Yevgeniy-Olexandrenko/aym-streamer/README.md

# AYM Streamer

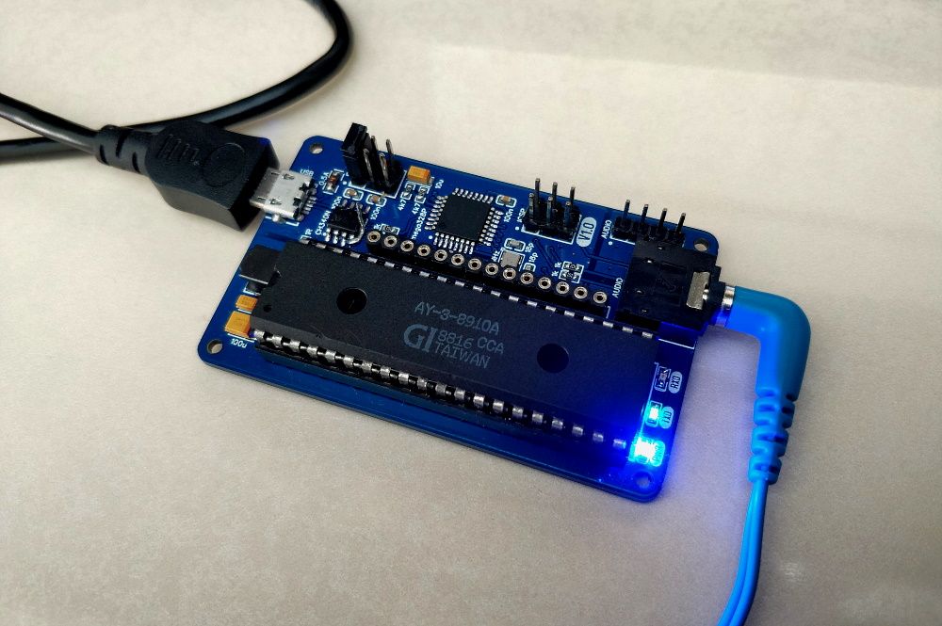
[picture p1: hardware/prototype.jpg]
