Yevgeniy-Olexandrenko/aym-streamer/hardware/README.md

PCB v1.1|PCB v1.2
-|-
|||
|||
|<div><ul><li>Fixed MCU-to-PSG data bus routing</li><li>Fixed MCU reset when uploading firmware via USB</li><li>First fully functional device</li></ul></div>|<ul><li>Micro USB input changed to USB Type-C</li><li>New trace routing for USB-to-Serial converter</li><li>L1 moved further away from the capacitors</li><li>More accurate traces around the MCU</li><li>New calculated resistors for LEDs</li><li>Added teardrops to traces</li><li>The device name is aligned along the PCB</li></ul>|
