Yevgeniy-Olexandrenko/aym-streamer/hardware/v1.2/AYM-Streamer-v1.2_LEDs.ods

Desired luminous intencity, mcd
10
FYLS-0603URC |  |  |  | FYLS-0603PGC |  |  |  | FYLS-0603UBC
RED |  |  |  | GREEN |  |  |  | BLUE
# | Uf, V | If, mA |  | # | Uf, V | If, mA |  | # | Uf, V | If, mA
1 | 1,70 | 1,00 |  | 1 | 2,60 | 0,50 |  | 1 | 2,60 | 1,00
2 | 1,75 | 1,75 |  | 2 | 2,65 | 1,00 |  | 2 | 2,65 | 1,50
3 | 1,80 | 2,50 |  | 3 | 2,70 | 1,50 |  | 3 | 2,70 | 2,00
4 | 1,85 | 4,50 |  | 4 | 2,75 | 2,50 |  | 4 | 2,75 | 2,75
5 | 1,90 | 6,50 |  | 5 | 2,80 | 3,50 |  | 5 | 2,80 | 3,50
6 | 1,95 | 9,00 |  | 6 | 2,85 | 4,75 |  | 6 | 2,85 | 5,00
7 | 2,00 | 11,50 |  | 7 | 2,90 | 6,00 |  | 7 | 2,90 | 6,50
8 | 2,05 | 13,75 |  | 8 | 2,95 | 7,00 |  | 8 | 2,95 | 7,25
9 | 2,10 | 16,00 |  | 9 | 3,00 | 8,00 |  | 9 | 3,00 | 8,00
10 | 2,15 | 20,50 |  | 10 | 3,05 | 10,25 |  | 10 | 3,05 | 10,25
11 | 2,20 | 25,00 |  | 11 | 3,10 | 12,50 |  | 11 | 3,10 | 12,50
 |  |  |  | 12 | 3,15 | 14,75 |  | 12 | 3,15 | 15,00
RED | GREEN | BLUE |  | 13 | 3,20 | 17,00 |  | 13 | 3,20 | 17,50
Iv, mcd @ If = 20 mA |  |  |  | 14 | 3,25 | 21,00 |  | 14 | 3,25 | 21,25
80 | 360 | 120 |  | 15 | 3,30 | 25,00 |  | 15 | 3,30 | 25,00
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
