Yevgeniy-Olexandrenko/aym-streamer/hardware/v1.2/AYM-Streamer-v1.2_BOM.tsv

ID | Name | Designator | Footprint | Quantity | Manufacturer Part | Manufacturer
1 | 100n | C4,C7,C8,C9,C10,C11,C15,C16,C20 | C0603 | 9
2 | 18p | C18,C19 | C0603 | 2
3 | 24K | R2,R4,R8,R11,R14,R19 | R0603 | 6
4 | 51R | R3,R15 | R0603 | 2
5 | 1K27 | R5 | R0603 | 1
6 | 4K3 | R6 | R0603 | 1
7 | 47K | R7,R13 | R0603 | 2
8 | 1K | R9,R10,R16,R17,R18 | R0603 | 5
9 | 1K4 | R21 | R0603 | 1
10 | 0R | R24 | R0603 | 1
11 | USB | USB1 | USB-C-7010ASV | 1 | GT-USB-7010ASV | G-Switch(品赞)
12 | 5.1K | R25,R26 | R0603 | 2
13 | TXD | LED2 | LED0603_GREEN | 1 | FYLS-0603PGC | FORYARD
14 | ATmega328P | U3 | TQFP-32_L7.0-W7.0-P0.80-LS9.0-BL | 1 | ATMEGA328P-AU | MICROCHIP
15 | 100u | C1,C6,C13 | CAP-SMD_L3.5-W2.8 | 3 | TAJB107K006RNJ | AVX
16 | 10u | C2,C3,C5,C12,C14,C17 | CAP-SMD_L3.2-W1.6-RD-1 | 6 | TAJA106K010RNJ | AVX
17 | 10K | R1,R12,R20,R22,R23 | R0603 | 5
18 | NE5532 | U1 | SOIC-8_L4.9-W3.9-P1.27-LS6.0-BL | 1 | NE5532DR | TI
19 | CH340N | U2 | SOP-8_L5.0-W4.0-P1.27-LS6.0-BL | 1 | CH340N | WCH(Jiangsu Qin Heng)
20 | PSG | LED3 | LED0603_BLUE | 1 | FYLS-0603UBC | FORYARD
21 | 1mH | L1 | IND-SMD_L5.8-W5.2_SCD0503T | 1 | YP0504-102M | YJYCOIN
22 | RXD | LED1 | LED0603_RED | 1 | FYLS-0603URC | FORYARD
23 | 16MHz | X1 | OSC-SMD_4P-L3.2-W2.5-BL | 1 | X3S027000BA1H-U | Harmony Elec
24 | 0.5A | F1 | F0805 | 1 | ASMD0805-050 | JDTFUSE
25 | AUDIO | CN1 | AUDIO-TH_PJ3F07-5P | 1 | PJ3F07-5P | SHOU HAN
