Yevgeniy-Olexandrenko/aym-streamer/hardware/v1.2/AYM-Streamer-v1.2_Schematic.pdf

AY-3-8912

# Mixer & Buffer

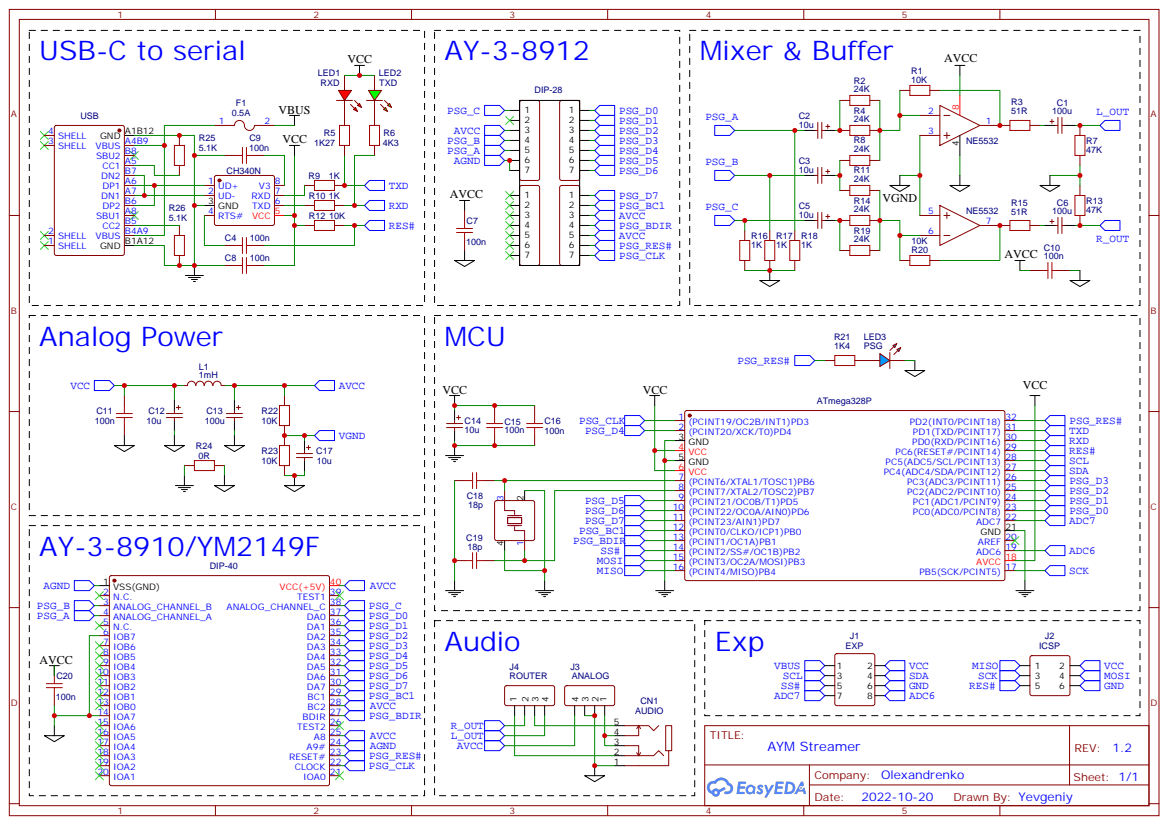
[picture p2: page 1]
