Yevgeniy-Olexandrenko/aym-streamer/hardware/v1.1/AYM-Streamer-v1.1_Schematic.pdf

AY-3-8912

# Mixer & Buffer

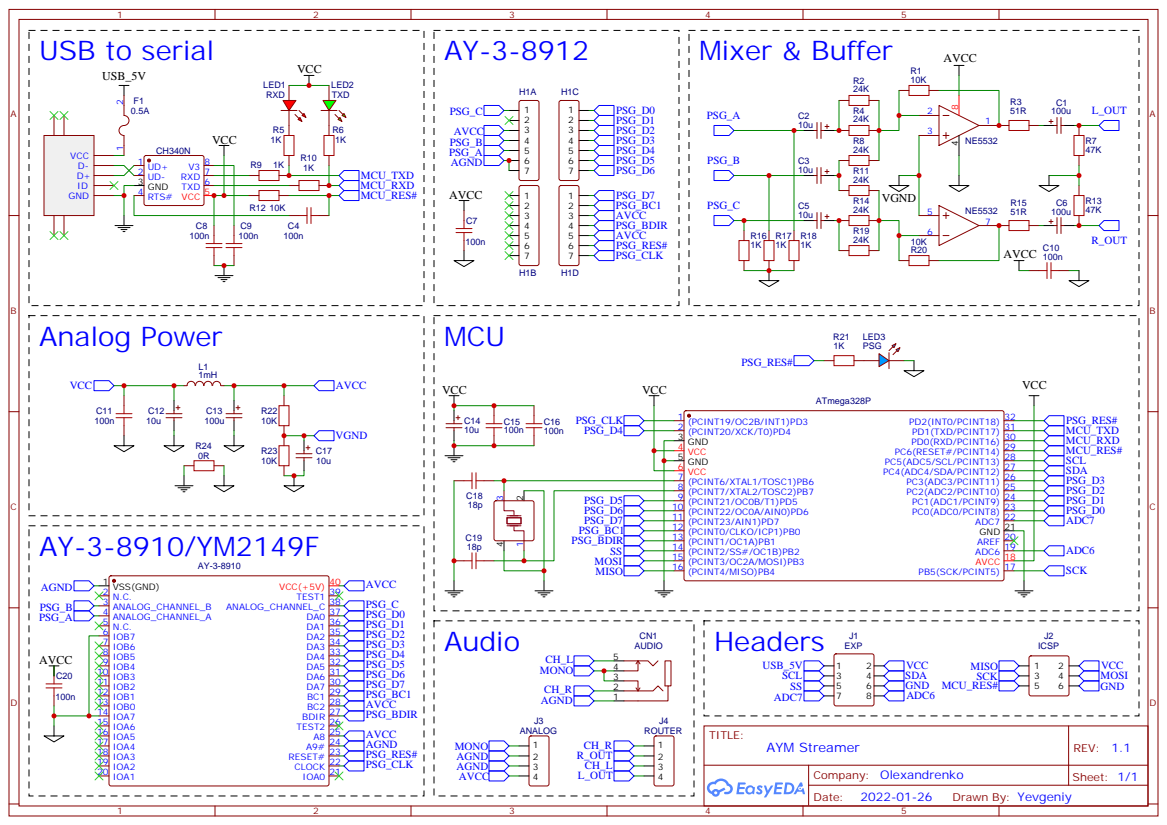
[picture p3: page 1]
