Yevgeniy-Olexandrenko/aym-streamer/(commit log)

2022-01-28 Added files for hardware
    [AYM-Streamer-v1.1_BOM.csv]
2022-02-04 Added interface for output devices
2022-02-07 Implementation for player with dedicated playback thread
2022-02-08 More stable playback frame rate + Refactoring
2022-02-11 Improved playback thread accuracy
2022-02-14 Improved the accuracy of playback thread + better files shuffling
2022-02-19 Added support for new board version 1.1
2022-04-21 Rewritten decoding procedure in VGM decoder and added frame rate detection
2022-05-05 New implementation for frame decoding
2022-05-13 Prepare for encoders implementation
2022-05-18 Added stub for AYM encoder/decoder implementation
2022-05-18 Added experimental implementation for AYM encoder
2022-05-19 More implementation on AYM encoder
2022-05-31 Added implementation for PSG encoder
2022-05-31 Fixed AYM encoder and PSG decoder
2022-07-25 Extend Frame to support all registers of AY8930
2022-07-25 Disabled processing of the loop frame for now
2022-07-25 Added implementation for output AY8930 compatible frames
2022-07-27 Added support for AY8930 in PSG encoder + refactoring
2022-07-27 Improvements in Frame component
2022-07-31 Simplified working with frames
2022-08-26 Search for frames duplicates test
2022-09-02 Detect frame rate for NES chip + refactoring
2022-09-02 Fixed reset data and changes in frame
2022-09-02 Implementation for better displaying of the stream frames
2022-09-03 Refactoring in frame registers access
2022-09-03 Improved PSG encoder and decoder
2022-09-04 Added test encoder for testing LZ78 compression of registers
2022-09-05 Working on AYM encoder
2022-09-09 Simplified frame visualization
2022-09-09 Fixed processing chain + chip clock rate conversion implementation
2022-09-10 Reworked frame display implementation
2022-11-02 Added new version of PCB
    [AYM-Streamer-v1.1_BOM.csv, AYM-Streamer-v1.2_BOM.csv]
2022-12-04 Fixed compilation and tested functionality
    [firmware_new.ino]
2023-01-28 Fixed clock conversion processing
    [firmware_new.ino]
2023-01-29 Added implementation for uart streamer
2023-01-29 Fixed uart stream algorithm
    [firmware_new.ino, uart-stream.cpp, uart-stream.h]
2023-01-29 Reduced size of buffer for uart stream
2023-01-31 Added implementation for text exchange via uart along with binary data reading
2023-02-01 Update bom file format
    [AYM-Streamer-v1.2_BOM.tsv]
2023-03-12 Added datashets for LEDs
2023-03-12 Update schematic and pcb with calculated resistors for leds
    [AYM-Streamer-v1.1_BOM.tsv, AYM-Streamer-v1.2_BOM.csv, AYM-Streamer-v1.2_BOM.tsv, AYM-Streamer-v1.2_LEDs.ods]
2024-08-13 Added drivers for USB-UART
2024-08-15 Fixed and improved PSG frequencies conversion accuracy
    [AdvancedAccess.cpp, AdvancedAccess.h, SimpleAccess.cpp]
2024-12-22 Working on new firmware based on PowerSG lib
2024-12-22 Added PowerSG lib
